tdorssers/Tetris/schematic/Tetris.sch

## EAGLE design schematic/Tetris.sch (2018-09-26)

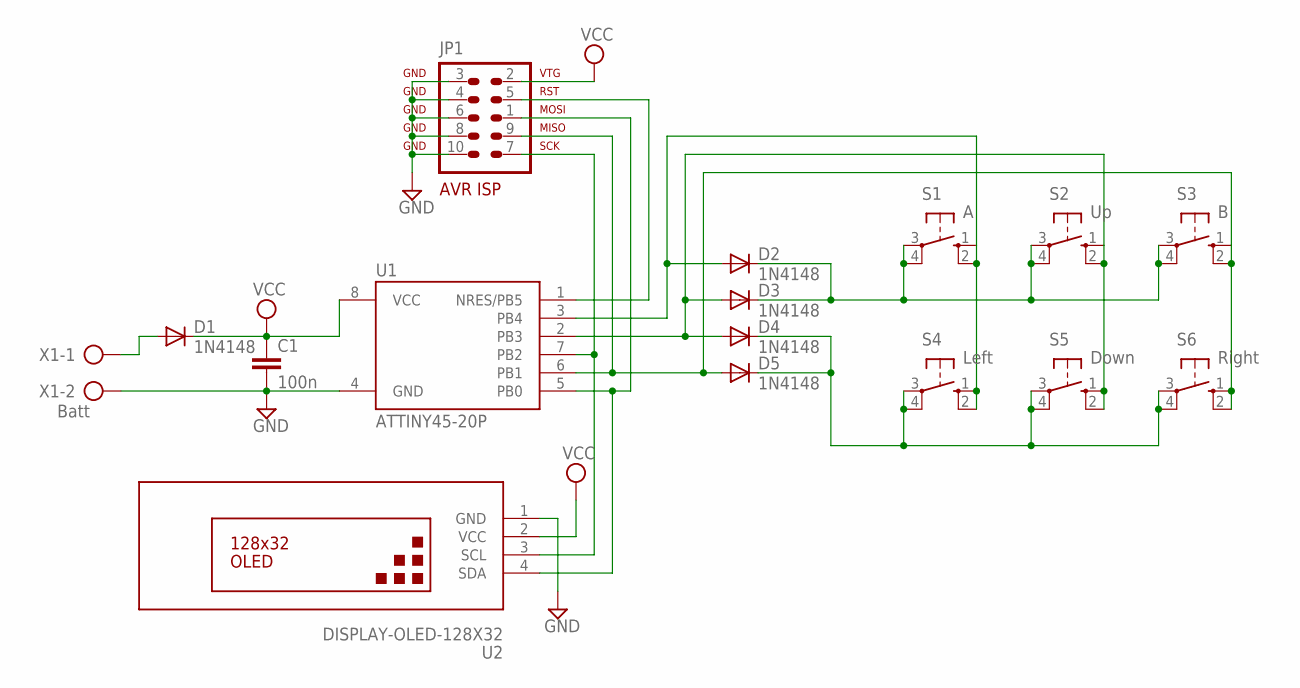
[picture p3: schematic Tetris.sch]

Parts:
C1: 100n; C025-024X044
D1, D2, D3, D4, D5: 1N4148; DO35-7
JP1: AVR-ISP-10
S1: A; B3F-10XX
S2: Up; B3F-10XX
S3: B; B3F-10XX
S4: Left; B3F-10XX
S5: Down; B3F-10XX
S6: Right; B3F-10XX
U1: ATTINY45-20P; PDIP08_300MIL
U2: DISPLAY-OLED-128X32
X1: Batt; AK500/2

Connections:
GND: C1.2, JP1.3, JP1.4, JP1.6, JP1.8, JP1.10, U1.4 (GND), U2.1 (GND), X1.2
unnamed: D1.A, X1.1
unnamed: D5.A, JP1.9, S3.1 (S), S3.2 (S1), S6.1 (S), S6.2 (S1), U1.6 (PB1)
unnamed: D3.A, D4.A, S2.1 (S), S2.2 (S1), S5.1 (S), S5.2 (S1), U1.2 (PB3)
unnamed: D2.A, S1.1 (S), S1.2 (S1), S4.1 (S), S4.2 (S1), U1.3 (PB4)
unnamed: D2.C, D3.C, S1.3, S1.4 (P1), S2.3, S2.4 (P1), S3.3, S3.4 (P1)
unnamed: D4.C, D5.C, S4.3, S4.4 (P1), S5.3, S5.4 (P1), S6.3, S6.4 (P1)
unnamed: JP1.5, U1.1 (NRES/PB5)
unnamed: JP1.1, U1.5 (PB0), U2.4 (SDA)
unnamed: JP1.7, U1.7 (PB2), U2.3 (SCL)
VCC: C1.1, D1.C, JP1.2, U1.8 (VCC), U2.2 (VCC)
